brandonbraun653/Luminary/Software/readme.md

Luminary
--------

Folder Structure
----------------
