brandonbraun653/Luminary/Hardware/KiCAD/LuminaryVer2/LuminaryVer2.kicad_pcb

## KiCad design Hardware/KiCAD/LuminaryVer2/LuminaryVer2.kicad_pcb (2020-07-23)

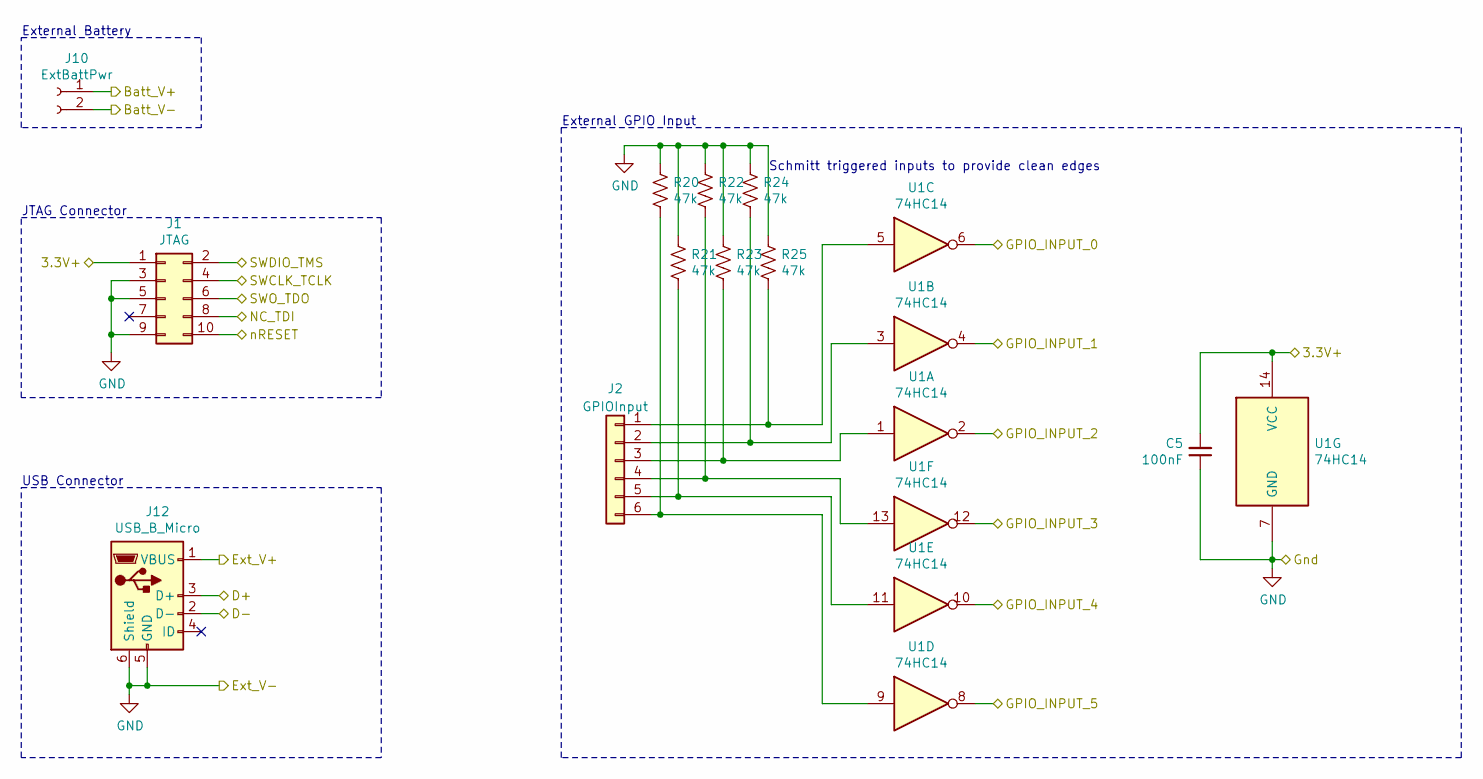
[picture p1: schematic InputConnectors.sch]

Parts:
C5: 100nF; C_0402_1005Metric; PartNumber CL05B104KO5NNNC; LCSC C1525
J1: JTAG; PinHeader_2x05_P1.27mm_Vertical; Mouser 649-221111-00010T4LF
J2: GPIOInput; PinHeader_1x06_P2.54mm_Vertical
J10: ExtBattPwr; PinHeader_1x02_P2.54mm_Vertical
J12: USB_B_Micro; Amphenol-MicroB; Mouser 798-ZX62D-B-5PA830
R20, R21, R22, R23, R24, R25: 47k; R_0402_1005Metric; PartNumber 0402WGF4702TCE; LCSC C25792
U1: 74HC14; SOIC-14_3.9x8.7mm_P1.27mm; PartNumber 74HC14PW,118; LCSC C5605

Connections:
+3V3: C5.2, J1.1, U1.14 (VCC); also elsewhere on the board
/Input Connectors/Batt_V+: J10.1; also elsewhere on the board
/Input Connectors/Batt_V-: J10.2; also elsewhere on the board
/Input Connectors/D+: J12.3 (D+); also elsewhere on the board
/Input Connectors/D-: J12.2 (D-); also elsewhere on the board
/Input Connectors/GPIO_INPUT_0: U1.6; also elsewhere on the board
/Input Connectors/GPIO_INPUT_1: U1.4; also elsewhere on the board
/Input Connectors/GPIO_INPUT_2: U1.2; also elsewhere on the board
/Input Connectors/GPIO_INPUT_3: U1.12; also elsewhere on the board
/Input Connectors/GPIO_INPUT_4: U1.10; also elsewhere on the board
/Input Connectors/GPIO_INPUT_5: U1.8; also elsewhere on the board
/Input Connectors/NC_TDI: J1.8
/Input Connectors/SWO_TDO: J1.6
/Input Connectors/nRESET: J1.10; also elsewhere on the board
/Power Supply/Ext_In+: J12.1 (VBUS); also elsewhere on the board
/Processor/SWCLK: J1.4; also elsewhere on the board
/Processor/SWDIO: J1.2; also elsewhere on the board
GND: C5.1, J1.3, J1.5, J1.9, J12.5 (GND), J12.6 (Shield), R20.1, R21.1, R22.1, R23.1, R24.1, R25.1, U1.7 (GND); also elsewhere on the board
unnamed: J2.1, R25.2, U1.5
unnamed: J2.2, R24.2, U1.3
unnamed: J2.3, R23.2, U1.1
unnamed: J2.4, R22.2, U1.13
unnamed: J2.5, R21.2, U1.11
unnamed: J2.6, R20.2, U1.9

Notes on the sheet:
Schmitt triggered inputs to provide clean edges
External GPIO Input
External Battery
JTAG Connector
USB Connector

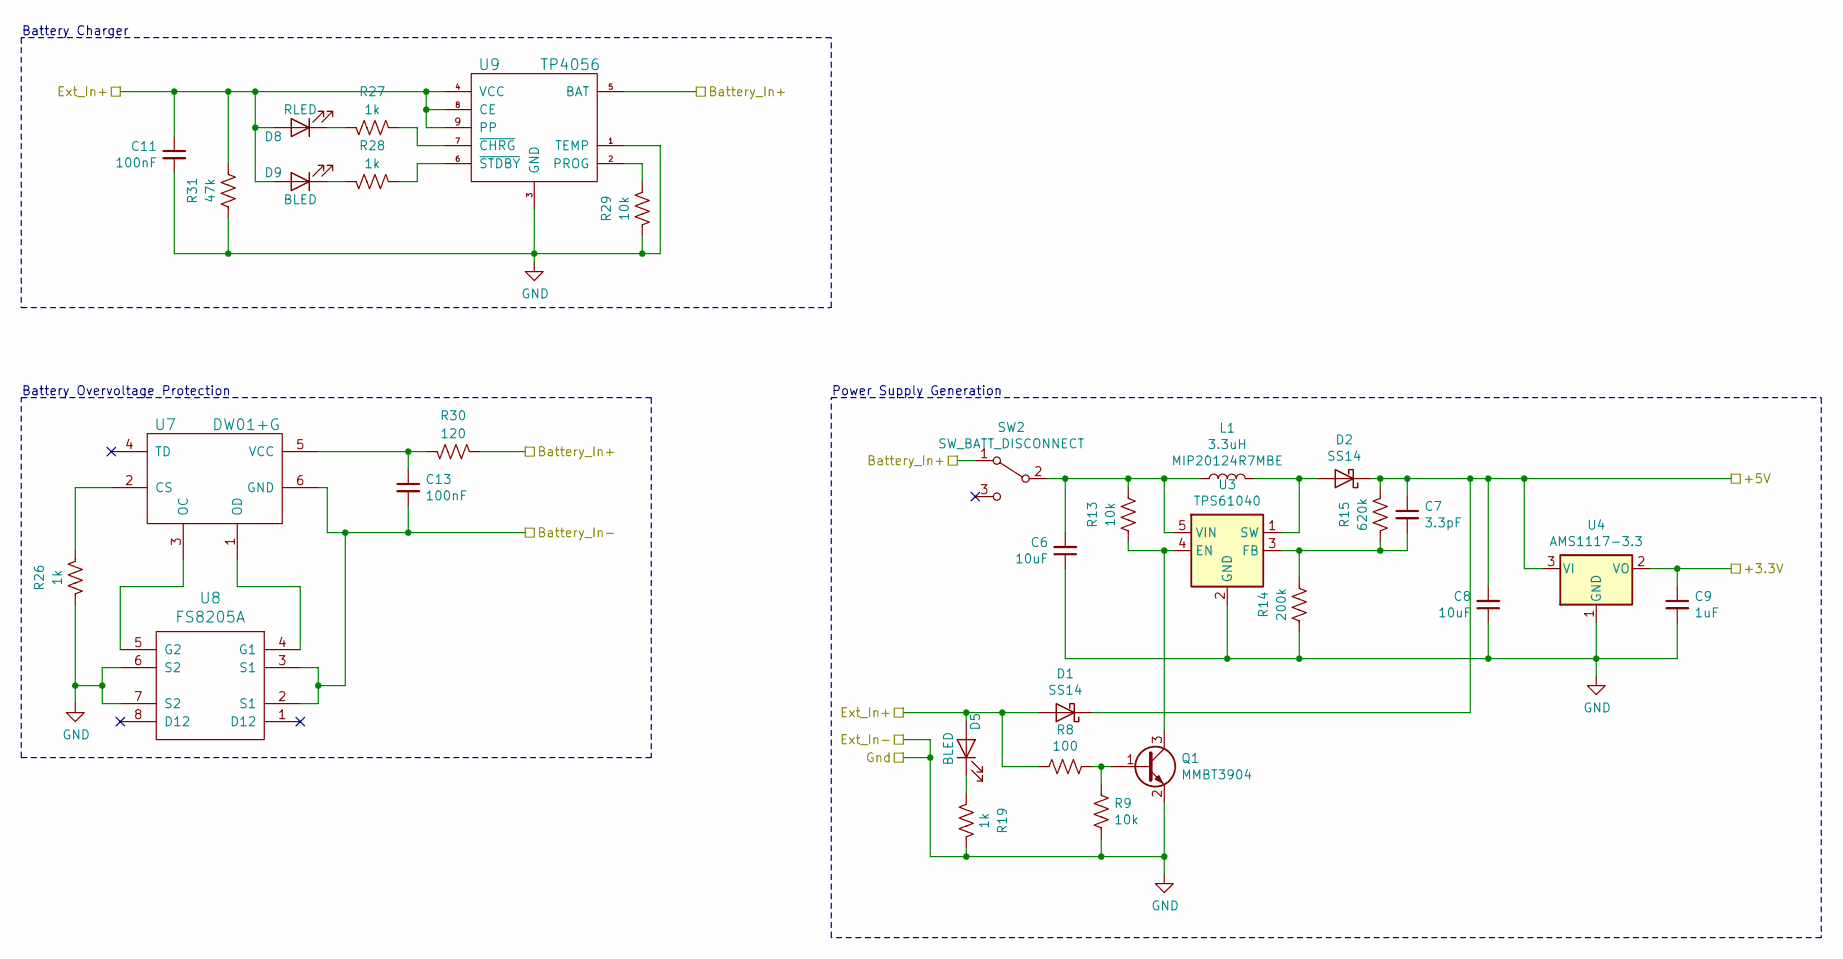
[picture p2: schematic PowerSupply.sch]

Parts:
C6, C8: 10uF; C_0805_2012Metric; PartNumber GRM21BB31A106KE18L; LCSC C15850
C7: 3.3pF; C_0402_1005Metric; PartNumber CL05B104KO5NNNC; LCSC C1565
C9: 1uF; C_0805_2012Metric; PartNumber CL21B105KBFNNNE; LCSC C28323
C11, C13: 100nF; C_0402_1005Metric; PartNumber CL05B104KO5NNNC; LCSC C1525
D1, D2: SS14; D_SMA; PartNumber SS16HE3_B/H; LCSC C2480
D5, D9: BLED; D_0603_1608Metric; PartNumber 19-217/BHC-ZL1M2RY/3T; LCSC C72041
D8: RLED; D_0603_1608Metric; PartNumber KT-0603R; LCSC C2286
L1: 3.3uH; L_0805_2012Metric; PartNumber MIP20124R7MBE; LCSC C51725
Q1: MMBT3904; SOT-23; LCSC C20526
R8: 100; R_0402_1005Metric; PartNumber RMC04021005%N; LCSC C25076
R9, R29: 10k; R_0402_1005Metric; PartNumber RTT02103JTH; LCSC C25744
R13: 10k; R_0402_1005Metric; PartNumber 0402WGF4702TCE; LCSC C25744
R14: 200k; R_0603_1608Metric; PartNumber 0402WGF4702TCE; LCSC C25811
R15: 620k; R_0603_1608Metric; PartNumber 0402WGF4702TCE; LCSC C23219
R19, R26, R27, R28: 1k; R_0402_1005Metric; PartNumber 0402WGF1001TCE; LCSC C11702
R30: 120; R_0402_1005Metric; PartNumber 0402WGF1200TCE; LCSC C25079
R31: 47k; R_0402_1005Metric; PartNumber 0402WGF4702TCE; LCSC C25792
SW2: SW_BATT_DISCONNECT; LCSC_C136659_HRO_SPDT_6.7x2.6mm_ToggleSwitch; PartNumber K3-1296S-E2; LCSC C136659
U3: TPS61040; SOT-23-5; LCSC C7722
U4: AMS1117-3.3; SOT-223-3_TabPin2; LCSC C6186
U7: DW01+G; SOT-23-6; PartNumber DW01A-G; LCSC C14213
U8: FS8205A; TSSOP-8_4.4x3mm_P0.65mm; PartNumber FS8205A; LCSC C16052
U9: TP4056; TP4056_SOP-8-PP; PartNumber TP4056; LCSC C16581

Connections:
+3V3: C9.1, U4.2 (VO); also elsewhere on the board
+5V: C7.1, C8.2, D1.1 (K), D2.1 (K), R15.1, U4.3 (VI); also elsewhere on the board
/Input Connectors/Batt_V+: R30.1, SW2.1 (A), U9.5 (BAT); also elsewhere on the board
/Input Connectors/Batt_V-: C13.2, U7.6 (GND), U8.2 (S1), U8.3 (S1); also elsewhere on the board
/Power Supply/Ext_In+: C11.1, D1.2 (A), D5.2 (A), D8.2 (A), D9.2 (A), R8.2, R31.2, U9.4 (VCC), U9.8 (CE), U9.9 (PP); also elsewhere on the board
GND: C6.1, C8.1, C9.2, C11.2, Q1.2 (E), R9.1, R14.1, R19.1, R26.2, R29.2, R31.1, U3.2 (GND), U4.1 (GND), U8.6 (S2), U8.7 (S2), U9.1 (TEMP), U9.3 (GND); also elsewhere on the board
unnamed: C6.2, L1.1, R13.2, SW2.2 (B), U3.5 (VIN)
unnamed: C7.2, R14.2, R15.2, U3.3 (FB)
unnamed: C13.1, R30.2, U7.5 (VCC)
unnamed: D2.2 (A), L1.2, U3.1 (SW)
unnamed: D5.1 (K), R19.2
unnamed: D8.1 (K), R27.2
unnamed: D9.1 (K), R28.2
unnamed: Q1.1 (B), R8.1, R9.2
unnamed: Q1.3 (C), R13.1, U3.4 (EN)
unnamed: R26.1, U7.2 (CS)
unnamed: R27.1, U9.7 (~CHRG)
unnamed: R28.1, U9.6 (~STDBY)
unnamed: R29.1, U9.2 (PROG)
unnamed: U7.1 (OD), U8.4 (G1)
unnamed: U7.3 (OC), U8.5 (G2)

Notes on the sheet:
Battery Charger
Battery Overvoltage Protection
Power Supply Generation

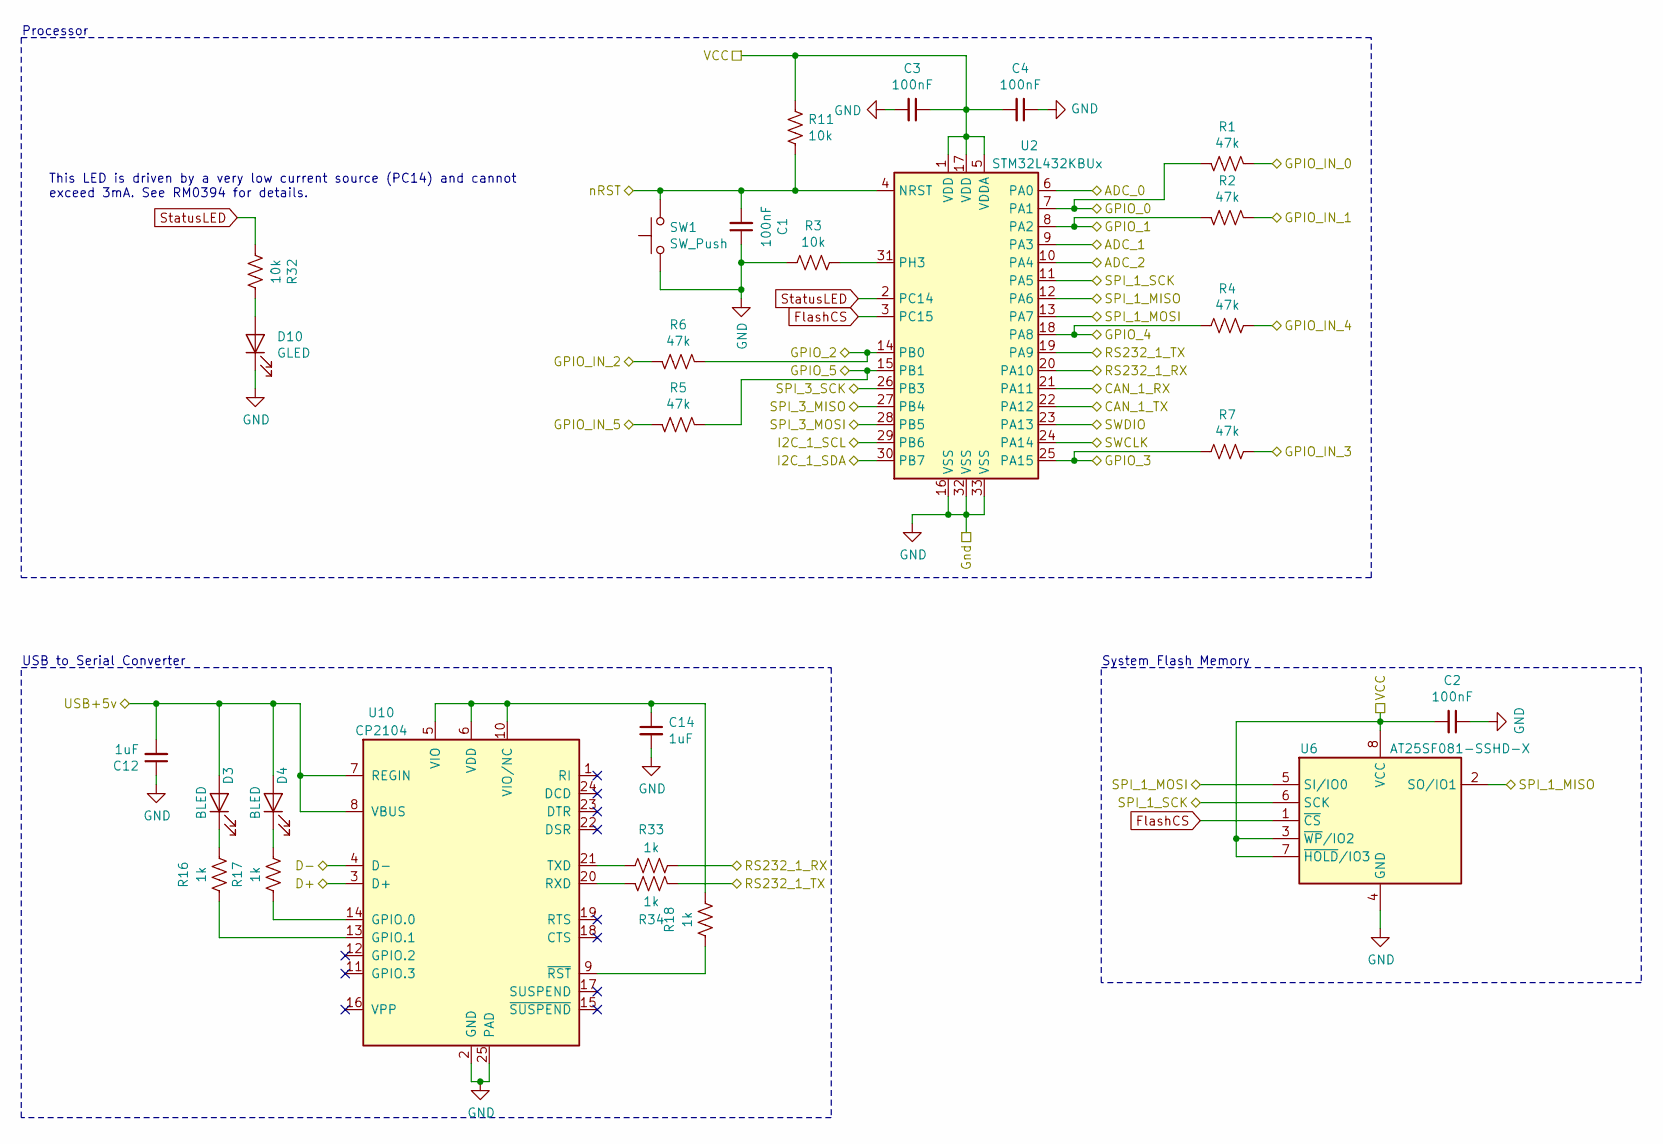
[picture p3: schematic Processor.sch]

Parts:
C1, C2, C3, C4: 100nF; C_0402_1005Metric; PartNumber CL05B104KO5NNNC; LCSC C1525
C12, C14: 1uF; C_0805_2012Metric; PartNumber CL21B105KBFNNNE; LCSC C28323
D3, D4: BLED; D_0603_1608Metric; PartNumber 19-217/BHC-ZL1M2RY/3T; LCSC C72041
D10: GLED; D_0603_1608Metric; PartNumber 19-217/GHC-YR1S2/3T; LCSC C72043
R1, R2, R4, R5, R6, R7: 47k; R_0402_1005Metric; PartNumber 0402WGF4702TCE; LCSC C25792
R3, R11, R32: 10k; R_0402_1005Metric; PartNumber RTT02103JTH; LCSC C25744
R16, R17, R18, R33, R34: 1k; R_0402_1005Metric; PartNumber 0402WGF4702TCE; LCSC C11702
SW1: SW_Push; LCSC_C255808_HYP_2x4x3.5mm_RightAngle; PartNumber 1TS003B-1600-3500A-CT; LCSC C255808
U2: STM32L432KBUx; QFN-32-1EP_5x5mm_P0.5mm_EP3.45x3.45mm; PartNumber STM32L432KBU6; LCSC C94784
U6: AT25SF081-SSHD-X; SOIC-8_3.9x4.9mm_P1.27mm; PartNumber AT25SF081-SSHD-B; LCSC C169368
U10: CP2104; QFN-24-1EP_4x4mm_P0.5mm_EP2.6x2.6mm; LCSC C47742

Connections:
+3V3: C2.2, C3.1, C4.2, R11.2, U2.1 (VDD), U2.5 (VDDA), U2.17 (VDD), U6.3 (~WP~/IO2), U6.7 (~HOLD~/IO3), U6.8 (VCC); also elsewhere on the board
/Input Connectors/D+: U10.3 (D+); also elsewhere on the board
/Input Connectors/D-: U10.4 (D-); also elsewhere on the board
/Input Connectors/GPIO_INPUT_0: R1.1; also elsewhere on the board
/Input Connectors/GPIO_INPUT_1: R2.2; also elsewhere on the board
/Input Connectors/GPIO_INPUT_2: R6.2; also elsewhere on the board
/Input Connectors/GPIO_INPUT_3: R7.2; also elsewhere on the board
/Input Connectors/GPIO_INPUT_4: R4.2; also elsewhere on the board
/Input Connectors/GPIO_INPUT_5: R5.2; also elsewhere on the board
/Input Connectors/nRESET: C1.2, R11.1, SW1.2, U2.4 (NRST); also elsewhere on the board
/Output Connectors/I2C_1_SCL: U2.29 (PB6); also elsewhere on the board
/Output Connectors/I2C_1_SDA: U2.30 (PB7); also elsewhere on the board
/Output Connectors/RS232_1_RX: R33.2, U2.20 (PA10); also elsewhere on the board
/Output Connectors/RS232_1_TX: R34.2, U2.19 (PA9); also elsewhere on the board
/Output Connectors/SPI_1_MISO: U2.12 (PA6), U6.2 (SO/IO1); also elsewhere on the board
/Output Connectors/SPI_1_MOSI: U2.13 (PA7), U6.5 (SI/IO0); also elsewhere on the board
/Output Connectors/SPI_1_SCK: U2.11 (PA5), U6.6 (SCK); also elsewhere on the board
/Output Connectors/SPI_2_MISO: U2.27 (PB4); also elsewhere on the board
/Output Connectors/SPI_2_MOSI: U2.28 (PB5); also elsewhere on the board
/Output Connectors/SPI_2_SCK: U2.26 (PB3); also elsewhere on the board
/Power Supply/Ext_In+: C12.2, D3.2 (A), D4.2 (A), U10.7 (REGIN), U10.8 (VBUS); also elsewhere on the board
/Processor/ADC_0: U2.6 (PA0); also elsewhere on the board
/Processor/ADC_1: U2.9 (PA3); also elsewhere on the board
/Processor/ADC_2: U2.10 (PA4); also elsewhere on the board
/Processor/CAN_1_RX: U2.21 (PA11); also elsewhere on the board
/Processor/CAN_1_TX: U2.22 (PA12); also elsewhere on the board
/Processor/GPIO_0: R1.2, U2.7 (PA1); also elsewhere on the board
/Processor/GPIO_1: R2.1, U2.8 (PA2); also elsewhere on the board
/Processor/GPIO_2: R6.1, U2.14 (PB0); also elsewhere on the board
/Processor/GPIO_3: R7.1, U2.25 (PA15); also elsewhere on the board
/Processor/GPIO_4: R4.1, U2.18 (PA8); also elsewhere on the board
/Processor/GPIO_5: R5.1, U2.15 (PB1); also elsewhere on the board
/Processor/SWCLK: U2.24 (PA14); also elsewhere on the board
/Processor/SWDIO: U2.23 (PA13); also elsewhere on the board
FlashCS: U2.3 (PC15), U6.1 (~CS)
GND: C1.1, C2.1, C3.2, C4.1, C12.1, C14.2, D10.1 (K), R3.2, SW1.1, U2.16 (VSS), U2.32 (VSS), U2.33 (VSS), U6.4 (GND), U10.2 (GND), U10.25 (PAD); also elsewhere on the board
unnamed: C14.1, R18.2, U10.5 (VIO), U10.6 (VDD), U10.10 (VIO/NC)
unnamed: D3.1 (K), R16.2
unnamed: D4.1 (K), R17.2
unnamed: D10.2 (A), R32.1
unnamed: R3.1, U2.31 (PH3)
unnamed: R16.1, U10.13 (GPIO.1)
unnamed: R17.1, U10.14 (GPIO.0)
unnamed: R18.1, U10.9 (~RST)
unnamed: R33.1, U10.21 (TXD)
unnamed: R34.1, U10.20 (RXD)
StatusLED: R32.2, U2.2 (PC14)

Notes on the sheet:
This LED is driven by a very low current source (PC14) and cannot exceed 3mA. See RM0394 for details.
USB to Serial Converter
System Flash Memory
Processor

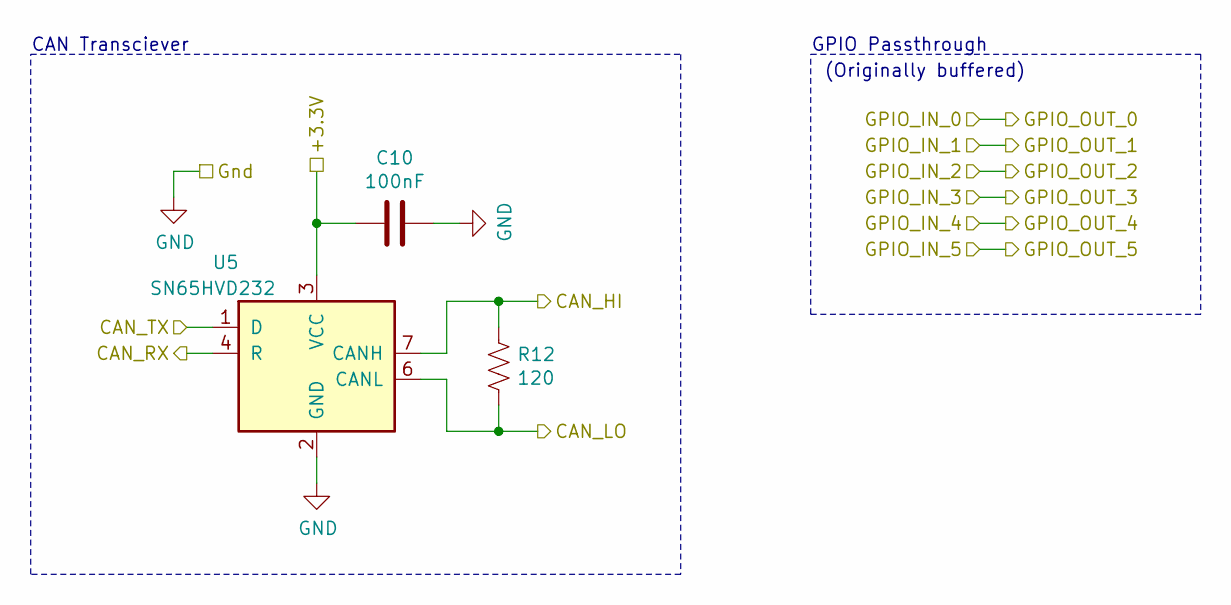
[picture p4: schematic OutputDrive.sch]

Parts:
C10: 100nF; C_0402_1005Metric; PartNumber CL05B104KO5NNNC; LCSC C1525
R12: 120; R_0402_1005Metric; PartNumber 0402WGF1200TCE; LCSC C25079
U5: SN65HVD232; SOIC-8_3.9x4.9mm_P1.27mm; PartNumber SN65HVD232DR; LCSC C30530

Connections:
+3V3: C10.2, U5.3 (VCC); also elsewhere on the board
/Output Connectors/CAN_1_HI: R12.1, U5.7 (CANH); also elsewhere on the board
/Output Connectors/CAN_1_LO: R12.2, U5.6 (CANL); also elsewhere on the board
/Processor/CAN_1_RX: U5.4 (R); also elsewhere on the board
/Processor/CAN_1_TX: U5.1 (D); also elsewhere on the board
GND: C10.1, U5.2 (GND); also elsewhere on the board

Notes on the sheet:
CAN Transciever
GPIO Passthrough
(Originally buffered)

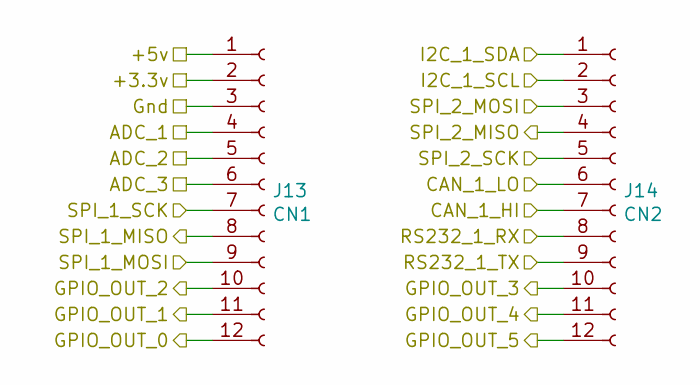
[picture p5: schematic OutputConnectors.sch]

Parts:
J13: CN1; PinHeader_1x12_P2.54mm_Vertical
J14: CN2; PinHeader_1x12_P2.54mm_Vertical

Connections:
+3V3: J13.2; also elsewhere on the board
+5V: J13.1; also elsewhere on the board
/Output Connectors/CAN_1_HI: J14.7; also elsewhere on the board
/Output Connectors/CAN_1_LO: J14.6; also elsewhere on the board
/Output Connectors/I2C_1_SCL: J14.2; also elsewhere on the board
/Output Connectors/I2C_1_SDA: J14.1; also elsewhere on the board
/Output Connectors/RS232_1_RX: J14.8; also elsewhere on the board
/Output Connectors/RS232_1_TX: J14.9; also elsewhere on the board
/Output Connectors/SPI_1_MISO: J13.8; also elsewhere on the board
/Output Connectors/SPI_1_MOSI: J13.9; also elsewhere on the board
/Output Connectors/SPI_1_SCK: J13.7; also elsewhere on the board
/Output Connectors/SPI_2_MISO: J14.4; also elsewhere on the board
/Output Connectors/SPI_2_MOSI: J14.3; also elsewhere on the board
/Output Connectors/SPI_2_SCK: J14.5; also elsewhere on the board
/Processor/ADC_0: J13.4; also elsewhere on the board
/Processor/ADC_1: J13.5; also elsewhere on the board
/Processor/ADC_2: J13.6; also elsewhere on the board
/Processor/GPIO_0: J13.12; also elsewhere on the board
/Processor/GPIO_1: J13.11; also elsewhere on the board
/Processor/GPIO_2: J13.10; also elsewhere on the board
/Processor/GPIO_3: J14.10; also elsewhere on the board
/Processor/GPIO_4: J14.11; also elsewhere on the board
/Processor/GPIO_5: J14.12; also elsewhere on the board
GND: J13.3; also elsewhere on the board

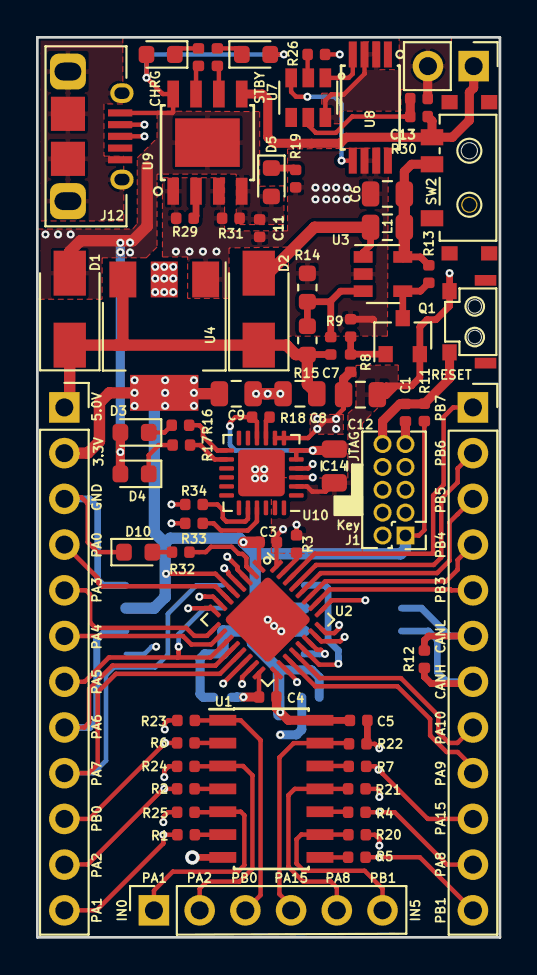
[picture p6: board LuminaryVer2.kicad_pcb from above]

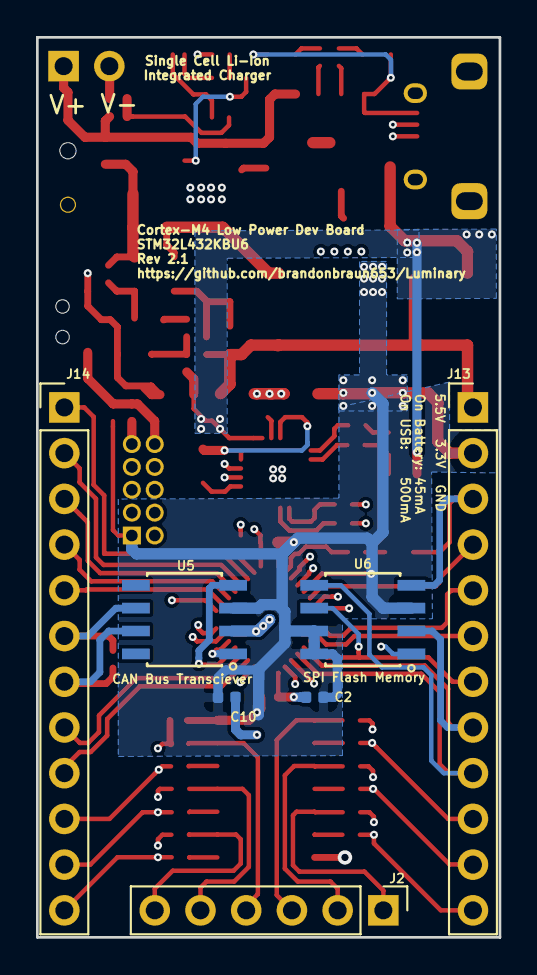
[picture p7: board LuminaryVer2.kicad_pcb from below]

Board: 4 copper layers, 25.7 x 50.0 mm, 75 parts (7 on the bottom side), 73 nets.
