brandonbraun653/Luminary/Hardware/KiCAD/LightDriverShieldVer2/LightDriverShieldVer2.kicad_pcb

## KiCad design Hardware/KiCAD/LightDriverShieldVer2/LightDriverShieldVer2.kicad_pcb (2020-07-23)

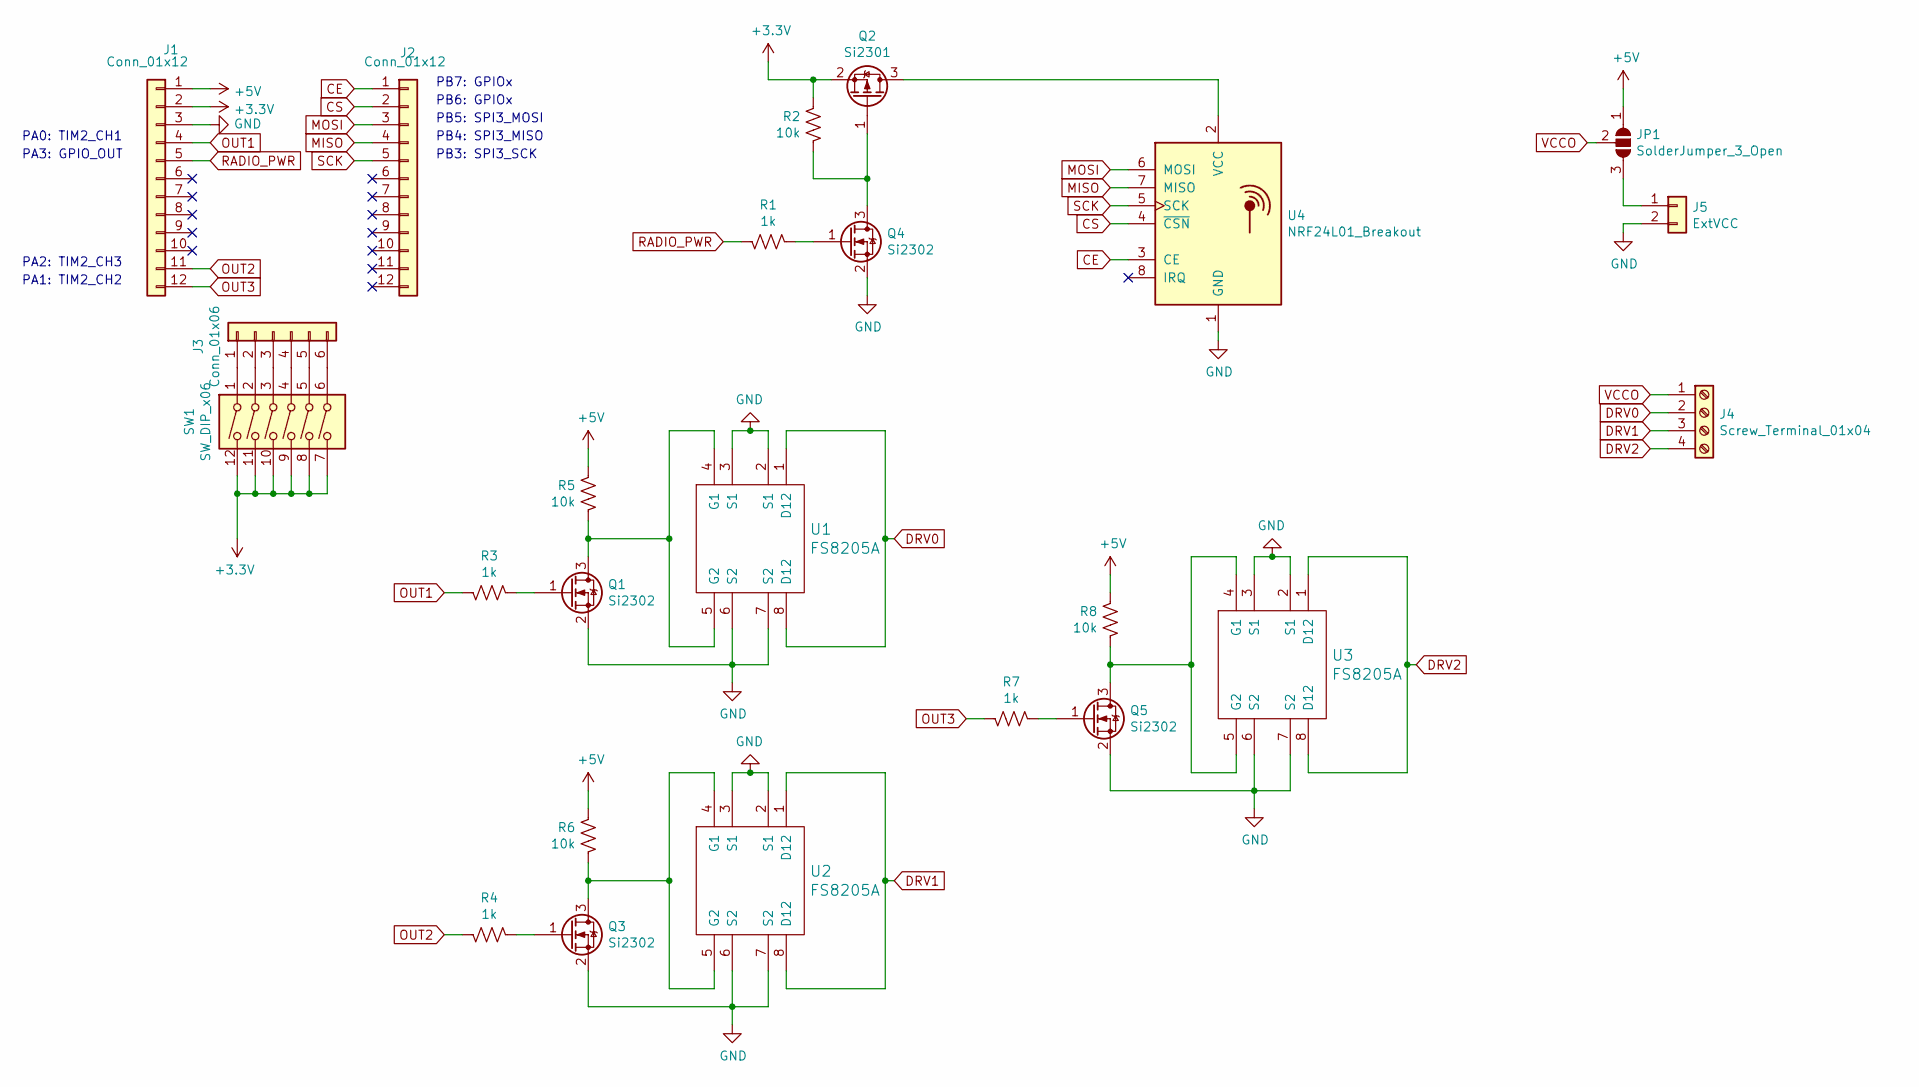
[picture p8: schematic LightDriverShieldVer2.sch]

Parts:
J1, J2: Conn_01x12; PinSocket_1x12_P2.54mm_Vertical
J3: Conn_01x06; PinSocket_1x06_P2.54mm_Vertical
J4: Screw_Terminal_01x04; TerminalBlock_TE_282834-4_1x04_P2.54mm_Horizontal
J5: ExtVCC; PinHeader_1x02_P2.54mm_Vertical
JP1: SolderJumper_3_Open; SolderJumper-3_P2.0mm_Open_TrianglePad1.0x1.5mm_NumberLabels
Q1, Q3, Q4, Q5: Si2302; SOT-23; LCSC C181087
Q2: Si2301; SOT-23; LCSC C10487
R1, R3, R4, R7: 1k; R_0402_1005Metric
R2, R5, R6, R8: 10k; R_0402_1005Metric
SW1: SW_DIP_x06; SW_DIP_SPSTx06_Slide_6.7x16.8mm_W7.62mm_P2.54mm_LowProfile
U1, U2, U3: FS8205A; TSSOP-8_4.4x3mm_P0.65mm; LCSC C16052
U4: NRF24L01_Breakout; nRF24L01_Breakout

Connections:
+3V3: J1.2, Q2.2 (S), R2.2, SW1.7, SW1.8, SW1.9, SW1.10, SW1.11, SW1.12
+5V: J1.1, JP1.1 (A), R5.2, R6.2, R8.2
CE: J2.1, U4.3 (CE)
CS: J2.2, U4.4 (~CSN)
DRV0: J4.2, U1.1 (D12), U1.8 (D12)
DRV1: J4.3, U2.1 (D12), U2.8 (D12)
DRV2: J4.4, U3.1 (D12), U3.8 (D12)
GND: J1.3, J5.2, Q1.2 (S), Q3.2 (S), Q4.2 (S), Q5.2 (S), U1.2 (S1), U1.3 (S1), U1.6 (S2), U1.7 (S2), U2.2 (S1), U2.3 (S1), U2.6 (S2), U2.7 (S2), U3.2 (S1), U3.3 (S1), U3.6 (S2), U3.7 (S2), U4.1 (GND)
MISO: J2.4, U4.7 (MISO)
MOSI: J2.3, U4.6 (MOSI)
unnamed: J3.1, SW1.1
unnamed: J3.2, SW1.2
unnamed: J3.3, SW1.3
unnamed: J3.4, SW1.4
unnamed: J3.5, SW1.5
unnamed: J3.6, SW1.6
unnamed: J5.1, JP1.3 (B)
unnamed: Q1.1 (G), R3.2
unnamed: Q1.3 (D), R5.1, U1.4 (G1), U1.5 (G2)
unnamed: Q2.1 (G), Q4.3 (D), R2.1
unnamed: Q2.3 (D), U4.2 (VCC)
unnamed: Q3.1 (G), R4.2
unnamed: Q3.3 (D), R6.1, U2.4 (G1), U2.5 (G2)
unnamed: Q4.1 (G), R1.2
unnamed: Q5.1 (G), R7.2
unnamed: Q5.3 (D), R8.1, U3.4 (G1), U3.5 (G2)
OUT1: J1.4, R3.1
OUT2: J1.11, R4.1
OUT3: J1.12, R7.1
RADIO_PWR: J1.5, R1.1
SCK: J2.5, U4.5 (SCK)
VCCO: J4.1, JP1.2 (C)

Notes on the sheet:
PA0: TIM2_CH1
PA1: TIM2_CH2
PA2: TIM2_CH3
PB7: GPIOx
PB6: GPIOx
PB3: SPI3_SCK
PB4: SPI3_MISO
PB5: SPI3_MOSI
PA3: GPIO_OUT

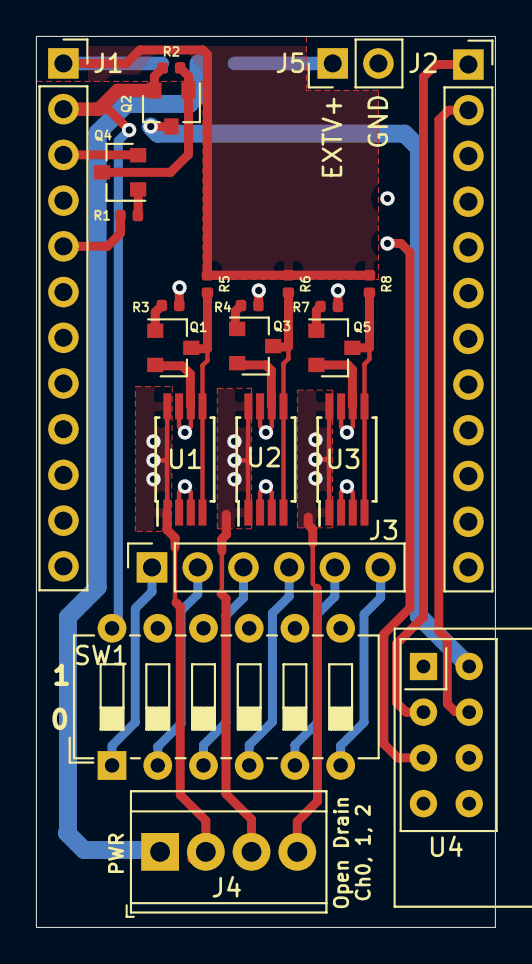
[picture p9: board LightDriverShieldVer2.kicad_pcb from above]

Board: 4 copper layers, 25.5 x 49.5 mm, 24 parts (1 on the bottom side), 32 nets.
