brandonbraun653/Luminary/Hardware/STM32CubePlanning/STM32CubePlanning.ioc

Mcu.UserName=STM32L432KBUx
PA0.Signal=ADCx_IN5
PA1.Signal=S_TIM2_CH2
PA10.Signal=USART1_RX
PA11.Signal=CAN1_RX
PA12.Signal=CAN1_TX
PA2.Signal=S_TIM2_CH3
PA3.Signal=ADCx_IN8
PA4.Signal=ADCx_IN9
PA5.Signal=SPI1_SCK
PA6.Signal=SPI1_MISO
PA7.Signal=SPI1_MOSI
PA8.Signal=S_TIM1_CH1
PA9.Signal=USART1_TX
PB0.Signal=GPIO_Output
PB1.Signal=GPIO_Input
PB5.Signal=SPI3_MOSI
PB6.Signal=I2C1_SCL
PB7.Signal=I2C1_SDA
PH3-BOOT0.Signal=GPIO_Input
