brandonbraun653/Luminary/Software/Luminary/logging/log_main.cpp

/********************************************************************************
 *  File Name:
 *    log_main.cpp
 *
 *  Description:
 *    Logging implementation for Luminary
 *
 *  2020 | Brandon Braun | brandonbraun653@gmail.com
 *******************************************************************************/

/* Aurora Includes */
#include <Aurora/logging/serial_sink.hpp>
#include <Aurora/logging/serial_sink_config.hpp>

/* Chimera Includes */
#include <Chimera/common>
#include <Chimera/event>
#include <Chimera/system>

/* uLog Includes */
#include <uLog/ulog.hpp>
#include <uLog/sinks/sink_vgdb_semihosting.hpp>

/* Luminary Includes */
#include <Luminary/config/config.hpp>
#include <Luminary/logging/log_main.hpp>
#include <Luminary/version.hpp>


namespace Chimera::Modules::uLog
{
 Chimera::Serial::IOPins SerialPins;
}


namespace Luminary::Logging
{
  /*-------------------------------------------------------------------------------
  Module Data
  -------------------------------------------------------------------------------*/
  static uLog::SinkHandle rootSink;


  /*-------------------------------------------------------------------------------
  Private Function Declarations
  -------------------------------------------------------------------------------*/
  static void printBootMessage();


  /*-------------------------------------------------------------------------------
  Public Functions
  -------------------------------------------------------------------------------*/
  void initializeModule()
  {
    /*------------------------------------------------
    Initialize the logger system
    ------------------------------------------------*/
    uLog::initialize();

#undef USING_VISUAL_GDB
#if defined( USING_VISUAL_GDB )
    rootSink = std::make_shared<uLog::VGDBSemihostingSink>();
    rootSink->setLogLevel( uLog::Level::LVL_DEBUG );
    rootSink->setName( "Root" );
    rootSink->enable();

    uLog::registerSink( rootSink );
    uLog::setGlobalLogLevel( uLog::Level::LVL_DEBUG );
    uLog::setRootSink( rootSink );
#else
    using namespace Chimera::Modules::uLog;
    rootSink = std::make_shared<SerialSink>( Chimera::Serial::Channel::SERIAL1, false );

    rootSink->setLogLevel( uLog::Level::LVL_DEBUG );
    rootSink->setName( "Root" );
    rootSink->enable();
    rootSink->open();

    uLog::registerSink( rootSink );
    uLog::setGlobalLogLevel( uLog::Level::LVL_DEBUG );
    uLog::setRootSink( rootSink );
#endif
  }


  void MainThread( void *argument )
  {
    Chimera::delayMilliseconds( STARTUP_DELAY_LOG_MAIN );

    initializeModule();
    printBootMessage();

    while( true )
    {
      Chimera::delayMilliseconds( MainThreadUpdateRate );
    }
  }


  uLog::SinkHandle getSystemLogger()
  {
    return rootSink;
  }

  /*-------------------------------------------------------------------------------
  Private Functions
  -------------------------------------------------------------------------------*/
  static void printBootMessage()
  {
    /*------------------------------------------------
    Initialize the buffer
    ------------------------------------------------*/
    size_t offset = 0;
    std::array<char, 100> bootMsg;
    bootMsg.fill( 0 );

    /*------------------------------------------------
    Format the boot string
    ------------------------------------------------*/
    offset += snprintf( bootMsg.data() + offset, bootMsg.size() - offset, "\nBooting up Luminary\r\n");
    offset += snprintf( bootMsg.data() + offset, bootMsg.size() - offset, "Luminary Version: %s\r\n", Luminary::Version.data() );
    offset += snprintf( bootMsg.data() + offset, bootMsg.size() - offset, "%s Version: %s\r\n",
                        Chimera::System::Description::backendDriverName().data(), Chimera::System::Version::asString().data() );

    /*------------------------------------------------
    Print out the boot message to the console
    ------------------------------------------------*/
    auto logger = uLog::getRootSink();
    if ( logger->try_lock_for( 100 ) )
    {
      logger->log( uLog::Level::LVL_DEBUG, bootMsg.data(), strlen( bootMsg.data() ) );
      Chimera::delayMilliseconds( 50 );
      logger->unlock();
    }
  }
}  // namespace Luminary::Loggin
