brandonbraun653/Luminary/Software/Luminary/networking/net_main.hpp

/********************************************************************************
 *  File Name:
 *    net_main.hpp
 *
 *  Description:
 *    Networking main thread for Luminary
 *
 *  2020 | Brandon Braun | brandonbraun653@gmail.com
 *******************************************************************************/

#pragma once
#ifndef LUMINARY_NETWORKING_THREAD_HPP
#define LUMINARY_NETWORKING_THREAD_HPP

/* STL Includes */
#include <cstddef>

/* Chimera Includes */
#include <Chimera/thread>

/* RF24 Includes */
#include <RF24Node/common>
#include <RF24Node/endpoint>

namespace Luminary::Network
{
  static constexpr auto MainThreadPriority     = Chimera::Threading::Priority::LEVEL_4;
  static constexpr size_t MainThreadUpdateRate = 5;
  static constexpr size_t MainThreadStackSize  = 2048;

  /**
   *  Initializes the entire Network module
   *  @return void
   */
  void initializeModule();

  /**
   *  Primary thread of execution for Networking related tasks
   *
   *  @param[in]  argument    Not used
   *  @return void
   */
  void MainThread( void *argument );

  /**
   *  Gets a reference to the radio object used to talk with the
   *  NRF24L01 device.
   *
   *  @return RF24::Endpoint::Interface_sPtr
   */
  RF24::Endpoint::Interface_sPtr getRadio();
}

#endif  /* !LUMINARY_NETWORKING_THREAD_HPP */
