brandonbraun653/Luminary/Software/Luminary/routines/animation_twinkle.hpp

/********************************************************************************
 *  File Name:
 *    animation_twinkle.hpp
 *
 *  Description:
 *    Declaration of the twinkle animation output for Luminary
 *
 *  2020 | Brandon Braun | brandonbraun653@gmail.com
 *******************************************************************************/

#pragma once
#ifndef LUMINARY_ANIMATION_TWINKLE_HPP
#define LUMINARY_ANIMATION_TWINKLE_HPP

/* Luminary Includes */
#include <Luminary/routines/types.hpp>

namespace Luminary::Routine::Twinkle
{
  extern AnimationSet animations;

  void construct();

}  // namespace Luminary::Routine::Twinkle

#endif  /* !LUMINARY_ANIMATION_TWINKLE_HPP */
