brandonbraun653/Luminary/Software/Luminary/routines/animation_flame.hpp

/********************************************************************************
 *  File Name:
 *    animation_flame.hpp
 *
 *  Description:
 *    Declaration of the sine wave animation output for Luminary
 *
 *  2020 | Brandon Braun | brandonbraun653@gmail.com
 *******************************************************************************/

#pragma once
#ifndef LUMINARY_ANIMATION_FLAME_HPP
#define LUMINARY_ANIMATION_FLAME_HPP

/* STL Includes */
#include <array>

/* Luminary Includes */
#include <Luminary/routines/types.hpp>

namespace Luminary::Routine::Flame
{
  extern AnimationSet animations;

  void construct();

}  // namespace Luminary::Routine::Flame

#endif  /* !LUMINARY_ANIMATION_FLAME_HPP */
