brandonbraun653/Luminary/(commit log)

2020-02-07 Added KiCAD project for PCB revision 1.
    [GPIOInputs.sch, InputConnectors.sch, LuminaryVer1.kicad_pcb, LuminaryVer1.sch, NRF24L01.sch, OutputConnectors.sch, OutputDrive.sch, PowerSupply.sch]
2020-02-08 Removed GPIO output driver to increase versatility as IO. Added passive over-current/voltage protection.
    [InputConnectors.sch, LuminaryVer1.sch, NRF24L01.sch, OutputConnectors.sch, OutputDrive.sch, PowerSupply.sch, Processor.sch]
2020-03-23 Added empty BOM for LCSC
    [LCSC_BOMVer2.xlsx]
2020-03-23 Added STM32Cube planning project.
2020-05-08 Added PMIC and charging circuitry. Minor refresh of existing components. Added KiCAD component lib.
    [LuminaryVer1.kicad_pcb]
2020-05-08 Added missing gitmodules entry for kicad parts repo
2020-05-09 Routed entire power section
    [LuminaryVer1.kicad_pcb, LuminaryVer1.sch, PowerSupply.sch, Processor.sch]
2020-05-13 Added majority of the logic level circuitry. Almost done routing connections.
    [InputConnectors.sch, LuminaryVer1.kicad_pcb, LuminaryVer1.sch, OutputConnectors.sch, Processor.sch]
2020-05-14 Finalized for version 1 production.
    [BOMLuminaryVer1.xlsx, InputConnectors.sch, LuminaryVer1.kicad_pcb, OutputDrive.sch, PowerSupply.sch, Processor.sch]
2020-05-18 Added embedded build project for Luminary. Created driver for the status LED. Submodule updates.
2020-05-18 Added power selection driver. Updated RF24Node and Thor drivers to try and figure out why SPI isn't writing.
2020-05-21 Added logging. Started working on getting the networking driver up and running.
2020-05-21 Fixed SPI communication issue by pulling up submodules.
    [net_main.cpp]
2020-05-21 Added empty project for led driver shield
    [LightDriverShieldVer1.kicad_pcb, LightDriverShieldVer1.sch]
2020-05-23 Pull up submodules to get Serial driver support. Added basic thread entry point for the RPC server.
2020-05-29 Pull up submodules. Implement a good chunk of the build system. Address a few build errors.
    [hwm_main.cpp, log_main.cpp]
2020-06-07 Added processing for auto-reconnection to the network. Started on V2 of luminary hardware. Pull up submodules.
    [BOMLuminaryVer1.xlsx, GPIOInputs.sch, InputConnectors.sch, LuminaryVer2.kicad_pcb, LuminaryVer2.sch, OutputConnectors.sch, OutputDrive.sch, PowerSupply.sch]
2020-06-08 Updated version 2 hardware schematics.
    [InputConnectors.sch, OutputDrive.sch, PowerSupply.sch, Processor.sch]
2020-06-08 Add silk screen overlay to pins. Redo GPIO input to use LCSC basic part.
    [InputConnectors.sch, LuminaryVer2.kicad_pcb]
2020-06-10 Laid out the power supply updates.
    [InputConnectors.sch, LuminaryVer2.kicad_pcb, PowerSupply.sch]
2020-06-10 Routed most of the signal layer.
    [LuminaryVer2.kicad_pcb]
2020-06-10 Version two nets fully routed.
    [LuminaryVer2.kicad_pcb, Processor.sch]
2020-06-10 Update some of the ground pours.
    [LuminaryVer2.kicad_pcb]
2020-06-11 Luminary V2 complete & sent off for manufacturing
    [BOMLuminaryVer1.xlsx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]
2020-06-13 Added initial schematic for Luminary daughter board.
2020-06-14 Routed the shield for version 1
    [LightDriverShieldVer1.kicad_pcb, LightDriverShieldVer1.sch]
2020-06-15 Shield version 1 ordered.
    [LightDriverShieldVer1-B_Cu.gbr, LightDriverShieldVer1-B_Mask.gbr, LightDriverShieldVer1-B_Paste.gbr, LightDriverShieldVer1-B_SilkS.gbr, LightDriverShieldVer1-Edge_Cuts.gbr, LightDriverShieldVer1-F_Cu.gbr, LightDriverShieldVer1-F_Mask.gbr, LightDriverShieldVer1-F_Paste.gbr]
2020-06-18 Generated interactive BOM for the lightdrivershield
    [LightDriverShieldVer1.kicad_pcb]
2020-06-26 Document a hardware bug with the power supply in version two of Luminary.
    [LuminaryVer2.kicad_pcb, PowerSupply.sch]
2020-06-30 Pull up submodules. Added PWM output driver.
2020-07-01 Rev the LightDriver board to version 2.
    [LightDriverShieldVer1.sch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]
2020-07-04 Hardware drivers reached stable operation. Transitioning to application layer development.
2020-07-05 Prototype animations working on the output drivers.
2020-07-09 Added Test project for exercising Luminary drivers.
2020-07-13 Update radio driver to pull in bug fix
2020-07-19 Integrated RF24 driver updates for improved network communication.
2020-07-21 Pull up RF24 driver for ShockBurst protocol implementation.
2020-07-23 Swapped MMBT3904 BJTs to SI2302 NMOS. Fixes bug where the B-E junction forces the GPIO pin controlling ON/OFF state to be clamped at ~0.6v.
    [LightDriverShieldVer2.kicad_pcb, LightDriverShieldVer2.sch]
2020-07-23 Finalized hardware 2.3
    [InputConnectors.sch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]
2020-08-06 Improve the radio driver.
2020-08-06 Candidate build 1.1.1. Extended mode changes to 5 minutes and mapped the network addresses.
    [WeddingNetworkMap.xlsx]
